TECHY-ENTHUSIAST/SIH26254-JalNaadi/docs/hardware_prototype.html

💧

# JalNaadi · Hardware Prototype

Smart India Hackathon 2026 · SIH-26254 · Ministry of Jal Shakti (NJJM) · Team SolveX TSDCEM (ID 128664)

NAADI-EAR · NAADI-GATE · NAADI-DESK

## 🔩 NAADI-EAR Node — Physical Assembly

## ⚡ Key Specifications

MCU

ESP32-WROVER-E

240 MHz dual-core · 8 MB PSRAM · Wi-Fi + BT

Vibration Sensor

ADXL345 / ADXL355

3200 Hz ODR · SPI @ 5 MHz · 13-bit, ±16g

Radio

SX1276 LoRa

866 MHz · 125 kHz BW · SF9 · 14 dBm · DoT licensed

Power

18650 + 1W Solar

Solar charged · TP4056 controller · deep-sleep 0.15 mA

Sampling Rate

3,200 Hz

10 s burst · 32,000 samples · 8-bit quantised for TX

Enclosure

IP67 ABS

Rubber pad + hose clamp · cable gland · field-deployable

Location Accuracy

≈ 0.06 m RMS

GCC-PHAT + One-Tap calibration · sync residual < 0.3 ms

Wake Interval

15 min

96 wake-checks / day · < 20 s active per cycle

Peer Sync

ESP-NOW

2.4 GHz Wi-Fi LAN · burst exchange < 250 B chunks · < 3 s

## 🔋 Power Chain

☀️ Solar
1W / 5V

→

TP4056
Charger

→

18650
3.7V / 3Ah

→

3.3V Reg
Low-Iq

→

ESP32
+ Peripherals

## 🔌 Wiring — ESP32-WROVER-E Pin Map

Signal | ESP32 Pin | Bus | Note
ADXL345 CS | GPIO 5 | VSPI | Chip select — accelerometer
ADXL345 SCK | GPIO 18 | VSPI | SPI clock 5 MHz, MODE3
ADXL345 MISO | GPIO 19 | VSPI | Data: sensor → ESP32
ADXL345 MOSI | GPIO 23 | VSPI | Data: ESP32 → sensor (config)
SX1276 CS | GPIO 15 | HSPI | Chip select — LoRa module
SX1276 SCK | GPIO 14 | HSPI | SPI clock
SX1276 MISO | GPIO 12 | HSPI | Data: LoRa → ESP32
SX1276 MOSI | GPIO 13 | HSPI | Data: ESP32 → LoRa
SX1276 DIO0 | GPIO 26 | IRQ | RxDone interrupt — beacon timestamp (IRAM ISR)
SX1276 RST | GPIO 25 | GPIO | Hardware reset
GATE Flow Pulse | GPIO 27 | GPIO | Hall sensor, internal pull-up (NAADI-GATE only)
GATE Pressure | GPIO 34 | ADC1 | 0.5–4.5 V transducer via voltage divider
VCC (3.3 V) | 3V3 | PWR | From low-Iq regulator, NOT USB chip in field
GND | GND | GND | Common ground plane

## 🛒 Bill of Materials — Per Node

# | Component | Qty | Cost (₹) | Note

1 | ESP32-WROVER-E module | 1 | 650 | 8 MB PSRAM for burst storage
2 | SX1276 LoRa module (865–867 MHz) | 1 | 700 | Antenna tuned 866 MHz
3 | ADXL345 breakout (prototype) | 1 | 300 | ADXL355 for field: ₹3,000
4 | 18650 Li-ion cell + holder | 1 | 350 | ~3 Ah capacity
5 | TP4056 solar charge controller | 1 | 120 | USB-C input compatible
6 | Solar panel 1W / 5V | 1 | 300 | Mini monocrystalline
7 | IP67 ABS enclosure + cable gland | 1 | 300 | ~100×70×50 mm
8 | Hose clamp + rubber pad | 1 | 150 | Pipe coupling / mechanical mount
9 | INA219 current monitor (test only) | 1 | 150 | Power budget verification
10 | Wiring, connectors, 866 MHz antenna | 1 | 150 | SMA pigtail, JST connectors
✅ Total per node (ADXL345 prototype) | | | ₹ 2,970 | Field version with ADXL355: ≈ ₹5,670

## 🏗️ Full System Architecture — Field Deployment

JalNaadi · SIH-26254 · Team SolveX TSDCEM (ID 128664) · Ministry of Jal Shakti / NJJM · MIT Licence · Firmware: Arduino / ESP32 · Backend: Python / FastAPI · Radio: 865–867 MHz DoT delicensed band
