TECHY-ENTHUSIAST/SIH26254-JalNaadi/docs/images/fig_night.png

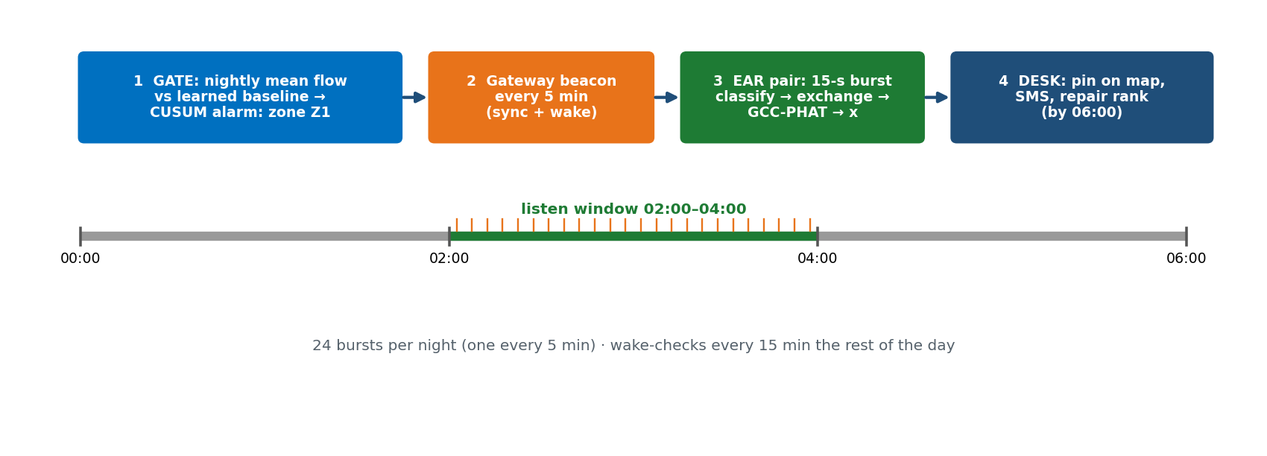
docs/images/fig_night.png
