TECHY-ENTHUSIAST/SIH26254-JalNaadi/docs/images/fig_node.png

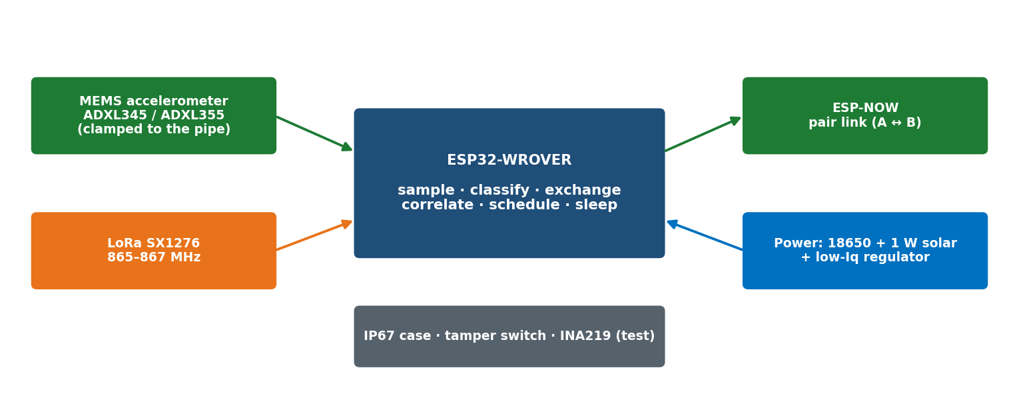
docs/images/fig_node.png
