TECHY-ENTHUSIAST/SIH26254-JalNaadi/docs/images/fig_rig.png

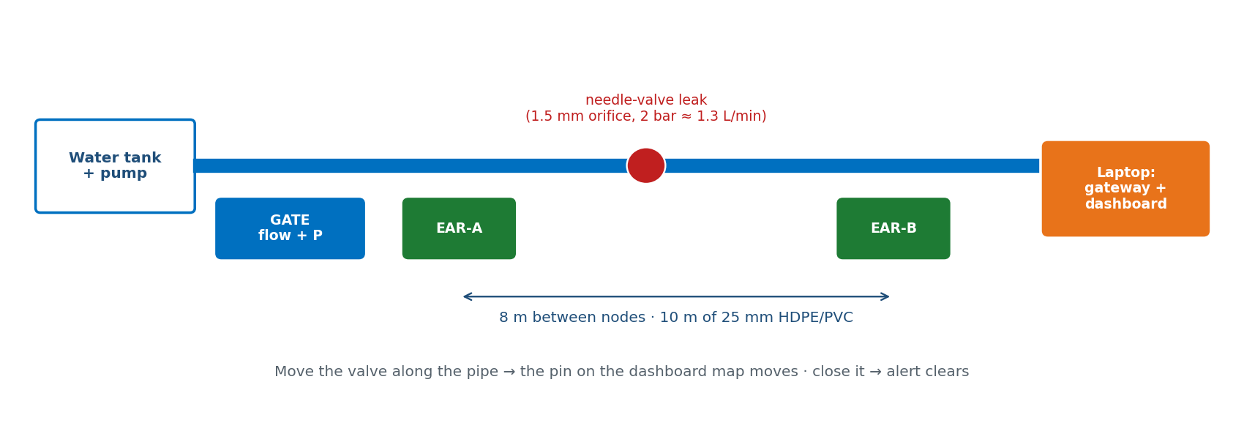
docs/images/fig_rig.png
