TECHY-ENTHUSIAST/SIH26254-JalNaadi/docs/images/fig_tdoa.png

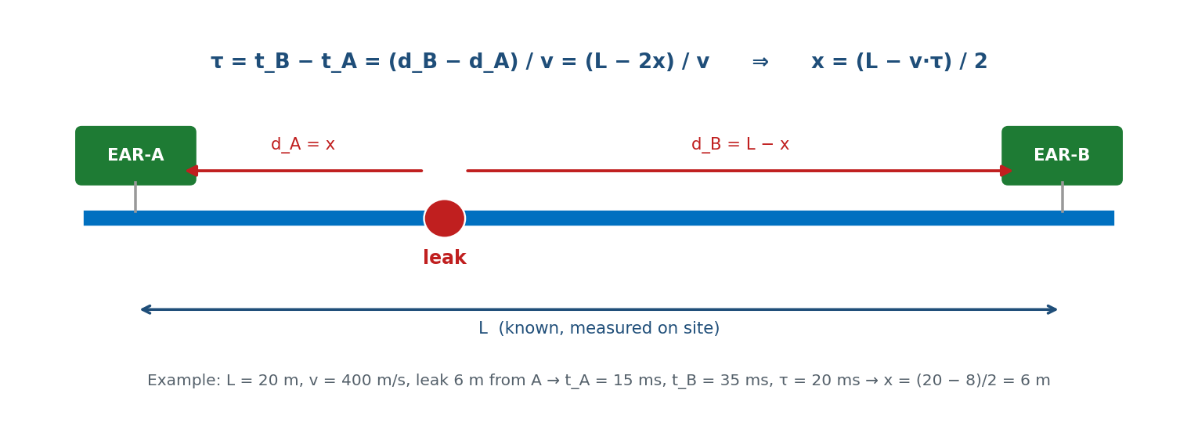
docs/images/fig_tdoa.png
