TECHY-ENTHUSIAST/SIH26254-JalNaadi/docs/images/sim_bits.png

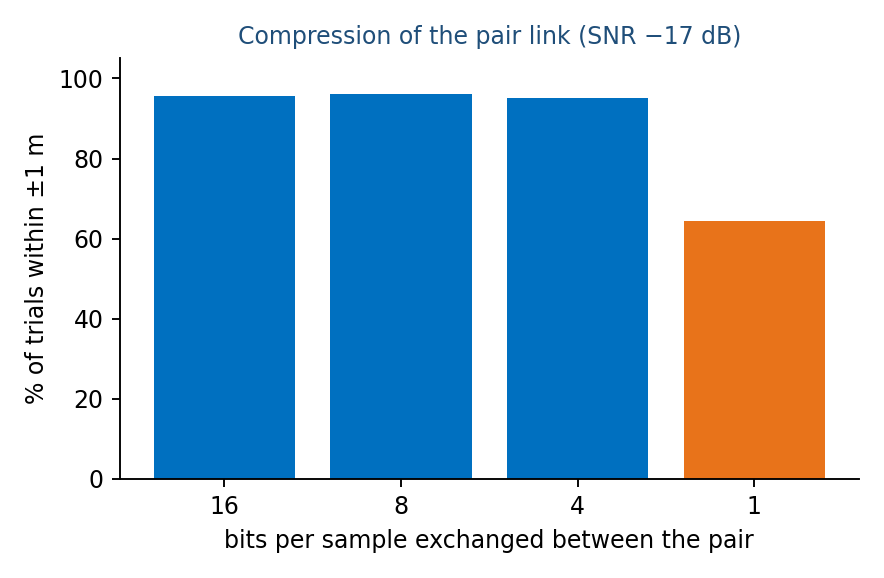
docs/images/sim_bits.png
