TECHY-ENTHUSIAST/SIH26254-JalNaadi/docs/images/sim_snr.png

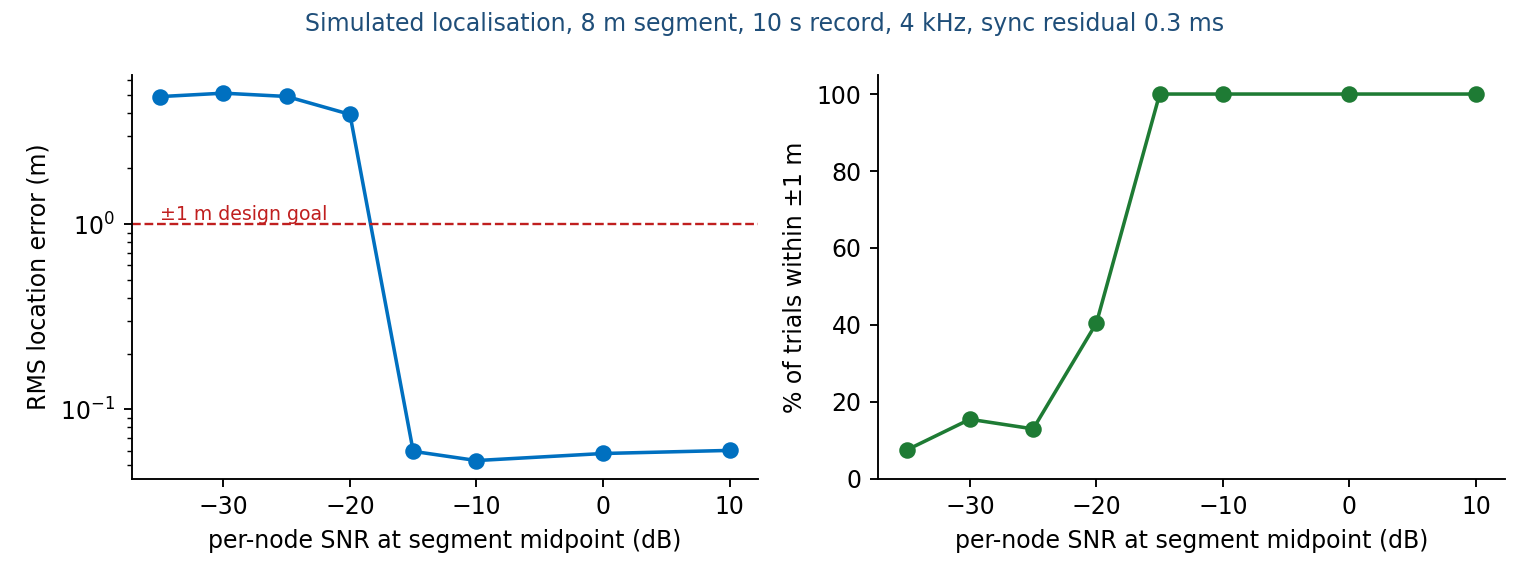
docs/images/sim_snr.png
