TECHY-ENTHUSIAST/SIH26254-JalNaadi/firmware/gateway/gateway.ino

// NAADI gateway reference skeleton (ESP32 + SX1276): sends sync/listen beacons, receives results, publishes to MQTT over TLS.
// STATUS: skeleton, not yet run on hardware.
#include <Arduino.h>
#include <WiFi.h>
#include <PubSubClient.h>
#include <RadioLib.h>
// TODO: set credentials / broker; use WiFiClientSecure with the broker CA certificate for MQTT-TLS.
void setup() { /* init LoRa @866.0 MHz, Wi-Fi/Ethernet/4G, MQTT; subscribe jalnaadi/cmd */ }
void loop() {
  // 1) During the listen window (02:00-04:00) and when GATE has flagged a zone: transmit a beacon every 5 min:
  //    radio.transmit("BCN,<epoch>,<seq>");  -> all EAR nodes timestamp its RxDone interrupt (reference-broadcast sync).
  //    A second beacon ~12 s later lets each node remove crystal drift.
  // 2) On LoRa RX: validate JSON (gid/did/dty/dt/p), publish to topic jalnaadi/uplink, keep a local 6-month store.
}
