TECHY-ENTHUSIAST/SIH26254-JalNaadi/(commit log)

2026-10-05 Initial commit: JalNaadi SIH-26254 project
    [BOM.csv]
2026-10-05 feat: add NAADI-DESK prototype dashboard image
2026-10-05 fix: add hardware prototype, pydantic dep, backend edge case, clean README
